bgamari/open-pd/(list of files, drawings)

Other design files:
power-meter.pcb
