bgamari/open-pd/(commit log)

2013-01-12 Create schematics list
2013-01-14 init: Clone to new directory, don't modify current
2013-06-04 Makefile: Add hackvana-gerbers
2013-06-04 hackvana-gerbers: Add outline file
2013-06-06 Remove gerbers directories before recreating
2014-01-10 Add schematics.pdf rule
2015-01-09 start project power-meter
    [power-meter.sch]
2015-01-10 More changes
    [power-meter.sch]
2015-01-10 Footprint attributes
    [power-meter.sch]
2015-01-10 Change button
    [power-meter.sch]
2015-01-10 Fix more footprints
    [power-meter.sch]
2015-01-10 Add layout
    [power-meter.pcb]
2015-01-11 Smaller buttons
    [power-meter.pcb, power-meter.sch]
2015-01-11 Fix silk
    [power-meter.pcb, power-meter.sch]
2015-01-11 More layout
    [power-meter.pcb, power-meter.sch]
2015-01-11 Add a second LED
    [power-meter.pcb, power-meter.sch]
2015-01-11 Flip around screen connector
    [power-meter.pcb]
2015-01-11 Add silk labels
    [power-meter.pcb]
2015-01-11 DRC issues
    [power-meter.pcb]
2015-01-11 Flip around silk label
    [power-meter.pcb]
2015-01-11 Place last cap
    [power-meter.pcb]
2015-01-11 Add silk
    [power-meter.pcb]
2015-01-11 Shuffle around buttons
    [power-meter.pcb, power-meter.sch]
2015-01-11 Shuffle silk
    [power-meter.pcb]
2015-01-11 Shuffle down SMA
    [power-meter.pcb]
2015-01-11 Add outline
    [power-meter.pcb, power-meter.sch]
2015-01-11 Don't place gain stage filter cap
    [power-meter.sch]
2015-01-11 Fix footprint conflict
    [power-meter.sch]
2015-01-11 Add JST battery connector
    [power-meter.pcb, power-meter.sch]
2015-01-11 Add 0.1" battery connector
    [power-meter.pcb, power-meter.sch]
2015-01-11 Add power options
2015-01-11 Add JST connector
2015-01-24 Make passive values more sane
    [power-meter.sch]
2015-01-24 Ensure VBAT is connected
    [power-meter.pcb, power-meter.sch]
2015-01-24 Add blocking diode for USB
    [power-meter.pcb, power-meter.sch]
2015-01-24 Fix amplifier polarity
    [power-meter.pcb, power-meter.sch]
2015-01-24 Fix reset button footprint
    [power-meter.pcb]
2015-01-24 Finally work out muxing
    [power-meter.sch]
2015-01-24 Fix voltage stage gain
    [power-meter.c]
2015-01-24 Switch ranges less spastically
2015-01-27 Add option to always sample both gain stages
2015-01-29 firmware: Fix stage2 gain
    [power-meter.c]
2015-01-30 Add flash calibration retention
2015-01-30 firmware: Fix potential overflow
    [power-meter.c]
2015-01-30 firmware: Write to correct FLASH memory
    [power-meter.c]
2015-01-30 firmware: Fix printing of gains
    [power-meter.c]
2015-01-30 firmware: Fix gain configuration interface
    [power-meter.c]
2015-02-18 Use default device name
2015-02-21 Add plot-power script
2015-04-23 host: Install plot-power
2015-04-29 host: Refactor to support multiple devices
2015-04-29 daemon: Monitor for new devices
2015-04-29 host: Perform initial search for devices
2015-04-29 Update inf driver file to match Arduino's. Both more compact and more complete.
2015-04-29 host: Don't add duplicate devices
2015-04-29 host: Remove device on IOError
2015-04-29 host: Add RawOpenPD.device_path
2015-04-29 daemon: Allow zero or more devices to be passed on command line
2015-04-29 host: Fix udev watching
    [openpd.py]
2015-04-29 host: Fix type error
    [openpd.py]
2015-04-29 openpd: Use udev device_node instead of device_path
2015-04-29 daemon: Fix udev monitoring
    [openpd.py]
2015-04-29 daemon: Handle case of device reappearance
2015-05-11 plot.js: Ensure socket is closed on page unload
2015-05-11 openpd: Be more robust against poorly behaving devices
2017-05-24 Update for python 3 compatibility and fix windows service
    [openpd-winsvc.py, openpd.py]
2017-05-24 Windows 7 x64 Hotfix for USBSER.SYS: Windows6.1-KB2990372-x64.msu fixes an issue of usbser.sys which failed to enumerate the OpenPD when removing and replugging in the device. This hotfix requires Wi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
2017-05-25 Fix python3, add displaying range to openpd script
    [openpd.py]
2017-05-25 Fix autoscale which in some instances would not progress to a higher range
    [power-meter.c]
2017-05-26 openpd.py: Fix adding of devices by pyudev monitor and implement removing of devices
    [openpd.py]
2017-05-26 openpd.py: throw error when daemon not running
    [openpd.py]
